alexey1234/arduino_hssp/schematic/README.md

# arduino_hssp programmer schematic

This is  my building of programmer hardware 

Such a complex circuit is needed because there are many more chips on my board that are powered by the same 5 Volt voltage. 

There are  many capacitors on the board also , so turning these 5 Volts on and off with a regular Arduino is quite problematic, an amplifier is needed

## My board

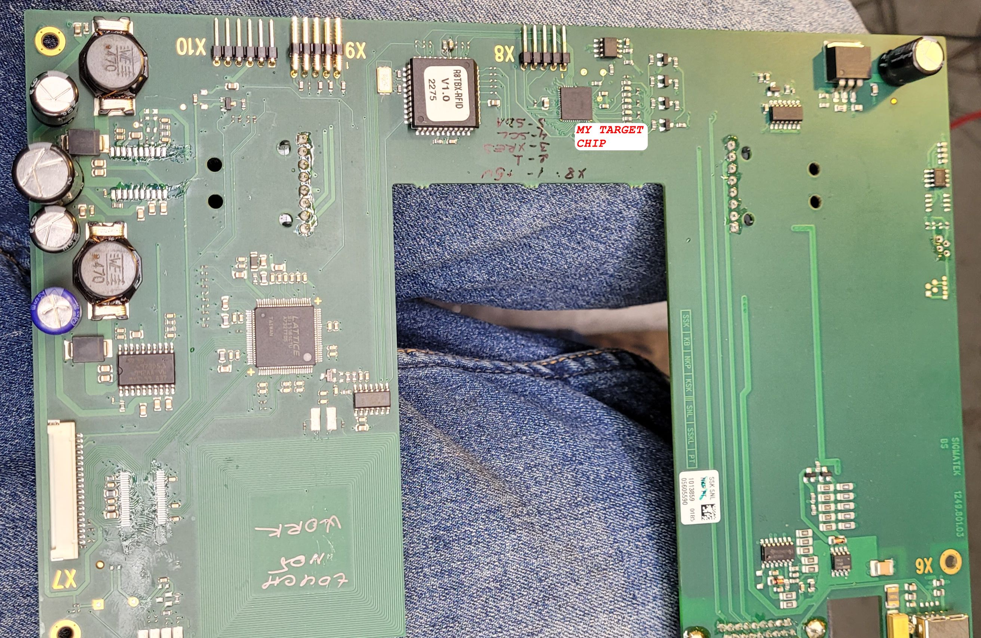
[picture p2: schematic/my target board.jpg]


## My programmer board schematic

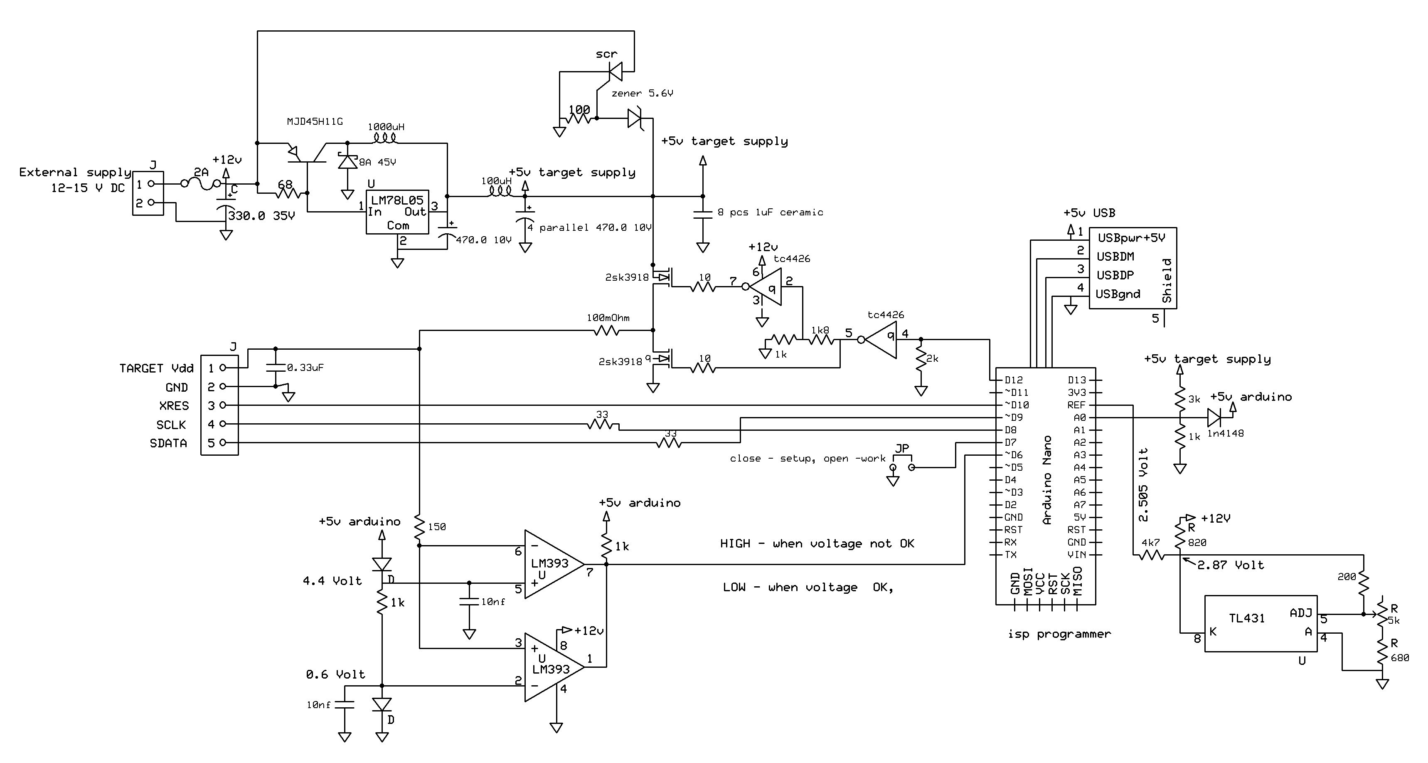
[picture p3: schematic/programmer_hard_V3.jpg]


I see more then 25 Amper peek curents during charge and discharge capacitor 100 uF on output.

I  use external voltage reference.

Time for charge and discharge some like 45 usec, so I add comparator for make delay as need.

[See test results](./test_result/README.md)
