alexey1234/arduino_hssp/linux/Cypress_psoc_tool/README.md

# Disc
This is copy of <https://github.com/trou/cypress_psoc_tools> 
trou, thank you very much for your work

# cypress_psoc_tools
Hackish tools to mess with Cypress PSoC 1, using an Arduino and <https://github.com/trou/arduino_hssp>

Example use case:
<https://syscall.eu/blog/2018/03/12/aigo_part2/>
