alexey1234/arduino_hssp/docs/execution of arduino command time.pdf

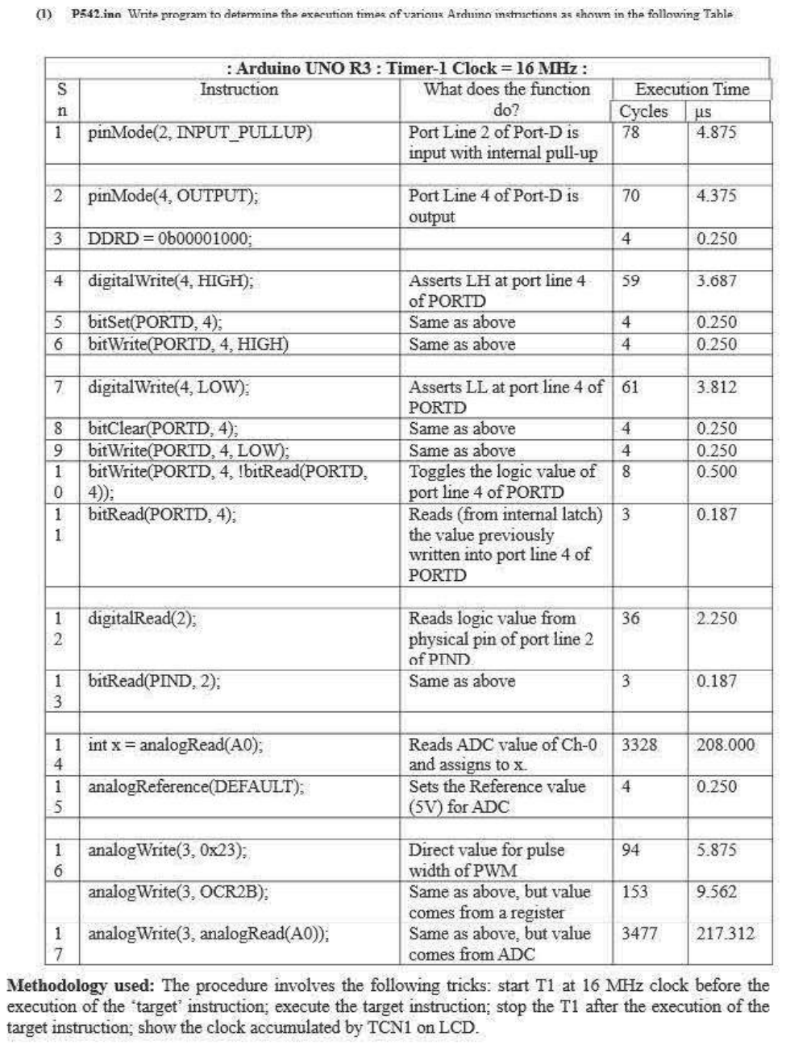
[picture p6: page 1]
