alexey1234/arduino_hssp/schematic/programmer.jpg

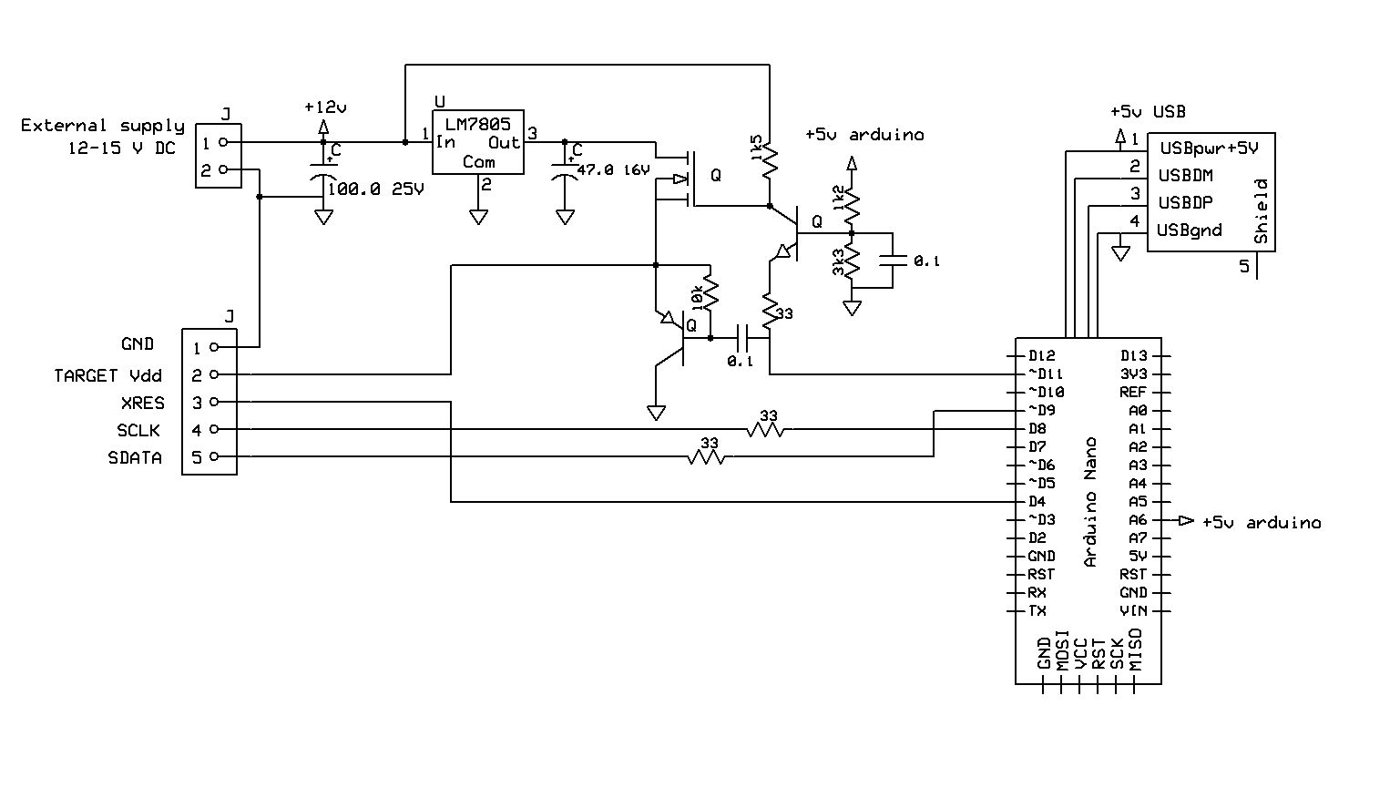
schematic/programmer.jpg
