alexey1234/arduino_hssp/schematic/programmer_V2.jpg

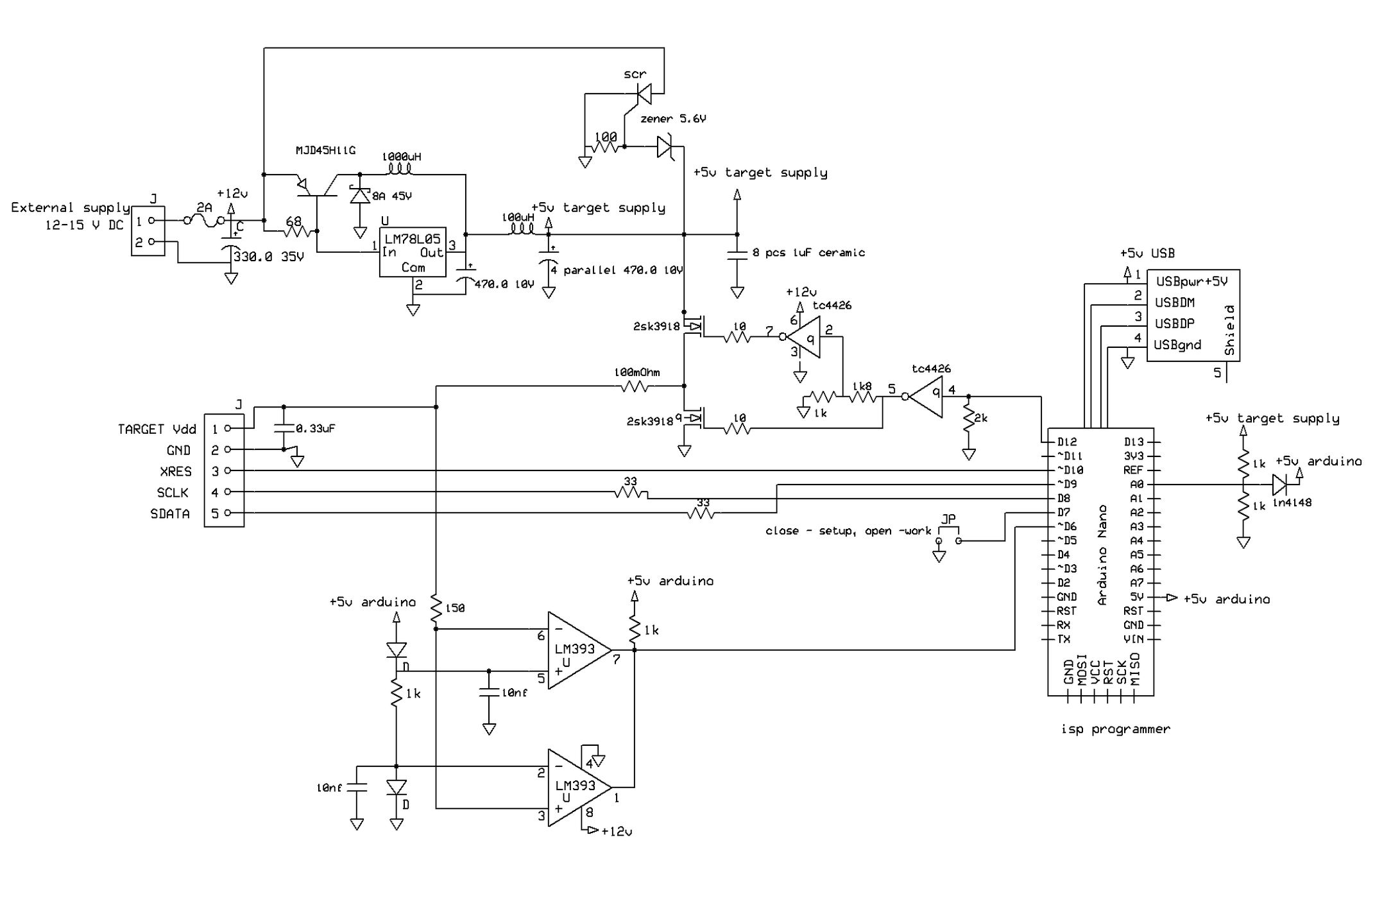
schematic/programmer_V2.jpg
