alexey1234/arduino_hssp/schematic/test_result/programmer_hard.jpg

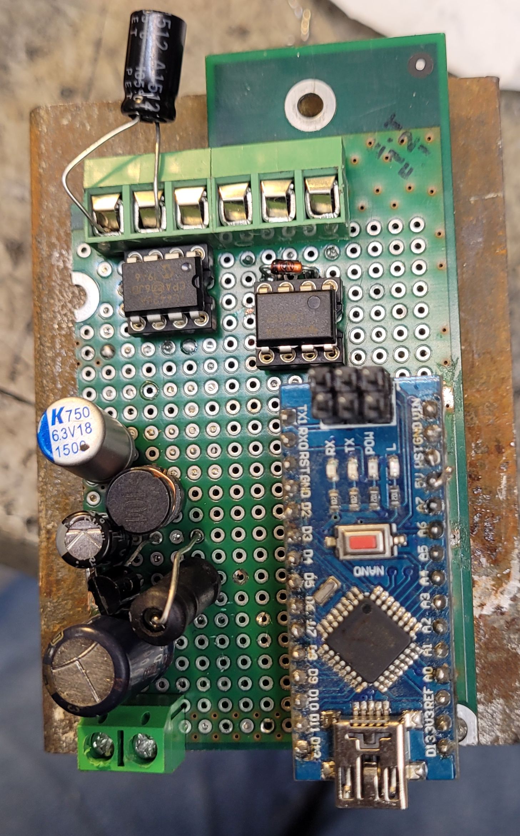
schematic/test_result/programmer_hard.jpg
