alexey1234/arduino_hssp/src/arduino_hssp.ino

/* Copyright 2006-2010, Cypress Semiconductor Corporation.
//
// This software is owned by Cypress Semiconductor Corporation (Cypress)
// and is protected by and subject to worldwide patent protection (United
// States and foreign), United States copyright laws and international 
// treaty provisions. Cypress hereby grants to licensee a personal, 
// non-exclusive, non-transferable license to copy, use, modify, create 
// derivative works of, and compile the Cypress Source Code and derivative 
// works for the sole purpose of creating custom software in support of 
// licensee product to be used only in conjunction with a Cypress integrated 
// circuit as specified in the applicable agreement. Any reproduction, 
// modification, translation, compilation, or representation of this 
// software except as specified above is prohibited without the express 
// written permission of Cypress.
//
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
// Use may be limited by and subject to the applicable Cypress software
// license agreement.
//
//---------------------------------------------------------------------------*/

/* ############################################################################
   ######  This version is configured to program HOTAS Warthog throttle  ######
   #####################   with an Arduino Pro Micro   ########################
   ##########################################################################*/

/* Pinout (see issp_defs.h):
   PCB - Arduino
   -------------
     1 - RAW
     2 - GND
     3 - 4
     4 - 8
     5 - 9
*/

/* ############################################################################
   ###################  CRITICAL PROJECT CONSTRAINTS   ########################
   ############################################################################ 

   ISSP programming can only occur within a temperature range of 5C to 50C.
   - This project is written without temperature compensation and using
     programming pulse-widths that match those used by programmers such as the
     Mini-Prog and the ISSP Programmer.
     This means that the die temperature of the PSoC device cannot be outside
     of the above temperature range.
     If a wider temperature range is required, contact your Cypress Semi-
     conductor FAE or sales person for assistance.

   The project can be configured to program devices at 5V or at 3.3V.
   - Initialization of the device is different for different voltages. The 
     initialization is hardcoded and can only be set for one voltage range.
     The supported voltages ranges are 3.3V (3.0V to 3.6V) and 5V (4.75V to
     5.25V). See the device datasheet for more details. If varying voltage
     ranges must be supported, contact your Cypress Semiconductor FAE or sales
     person for assistance.
   - ISSP programming for the 2.7V range (2.7V to 3.0V) is not supported.

   This program does not support programming all PSoC Devices 
   - It does not support obsoleted PSoC devices. A list of devices that are
     not supported is shown here:
         CY8C22x13 - not supported
         CY8C24x23 - not supported (CY8C24x23A is supported)
         CY8C24x33 - not supported
         CY8C25x43 - not supported
         CY8C26x43 - not supported
		 
   - Note: There is another application note (AN59389) that supports HSSP programming
     for CY8C20xx6, CY8CTMG2xx, CY8CTST2xx.
	 
   - It does not suport devices that have not been released for sale at the 
     time this version was created. If you need to ISSP program a newly released
     device, please contact Cypress Semiconductor Applications, your FAE or 
     sales person for assistance.
     The CY8C20x23 devices are not supported at the time of this release.

   ############################################################################ 
   ##########################################################################*/

     
/* This program uses information found in Cypress Semiconductor application 
// notes "Programming - In-System Serial Programming Protocol", AN2026.  The 
// version of this application note that applies to the specific PSoC that is
// being In-System Serial Programmed should be read and and understood when 
// using this program. (http://www.cypress.com)

// This project is included with releases of PSoC Programmer software. It is 
// important to confirm that the latest revision of this software is used when
// it is used. The revision of this copy can be found in the Project History 
// table below.
*/

/*/////////////////////////////////////////////////////////////////////////////
//  PROJECT HISTORY
//  date      revision  author  description
//  --------  --------  ------  -----------------------------------------------
//
//  12/06/10  ?2.30?     vvsk   1. Added support for CY8C21x45, CY8C22x45, CY8C23x33 
//
//                              2. Changed Revision to REV230
// 
//  xx/xx/10  ?2.20?     xch    1. Added support for CY8C20x34, CY8CTST110, CY8CTST120, 
//                              CY8CTMG110, CY8CTMG120, CY8CTMA120, 
//
//                              2. Aligned the order of parameters for LoadProgramData 
//                                 per CDT45137 
//
//                              3. Changed timing equation since CPU is now at 12MHz
//                                 instead of 24MHz.  Equation is now 2x+7 was 1x+3
//
//                              4. Changed Revision to REV220
//
//	02/09/09  2.12       fkl    1. Added vectors and constant defs for CY8C28xxx.
//
//								2. Changed constant definitions in files
//								issp_directives.h, issp_vectors.h and issp_defs.h.
//
//								3. Changed version number to REV212
//
//  09/23/07  2.11       dkn    1. Added searchable comments for the HSSP app note.
//
//                              2. Added new device vectors.
//
//                              3. Verified write and erase pulsewidths.
//
//                              4. Modified some functions for easier porting to
//                              other processors.
//
//  09/23/06  2.10       mwl    1. Added #define SECURITY_BYTES_PER_BANK to
//                              file issp_defs.h. Modified function
//                              fSecureTargetFlashMain() in issp_routines.c
//                              to use new #define. Modified function
//                              fLoadSecurityData() in issp_driver_routines.c
//                              to accept a bank number.  Modified the secure
//                              data loop in main.c to program multiple banks.
//
//                              2. Created function fAccTargetBankChecksum to
//                              read and add the target bank checksum to the
//                              referenced accumulator.  This allows the
//                              checksum loop in main.c to function at the
//                              same level of abstraction as the other
//                              programming steps.  Accordingly, modified the 
//                              checksum loop in main.c.  Deleted previous
//                              function fVerifyTargetChecksum().
//
//  09/08/06  2.00       mwl    1. Array variable abTargetDataOUT was not
//                              getting intialized anywhere and compiled as a
//                              one-byte array. Modified issp_driver_routines.c
//                              line 44 to initialize with TARGET_DATABUFF_LEN.
//
//                              2. Function void LoadProgramData(unsigned char
//                              bBlockNum) in issp_driver_routines.c had only
//                              one parameter bBlockNum but was being called
//                              from function main() with two parameters,
//                              LoadProgramData(bBankCounter, (unsigned char)
//                              iBlockCounter).  Modified function 
//                              LoadProgramData() to accept both parameters,
//                              and in turn modified InitTargetTestData() to 
//                              accept and use both as well.
//
//                              3. Corrected byte set_bank_number[1]
//                              inissp_vectors.h.  Was 0xF2, correct value is
//                              0xE2.
//
//                              4. Corrected the logic to send the SET_BANK_NUM
//                              vectors per the AN2026B flow chart.The previous
//                              code version was sending once per block, but
//                              should have been once per bank.  Removed the
//                              conditionally-compiled bank setting code blocks
//                              from the top of fProgramTargetBlock() and
//                              fVerifyTargetBlock() int issp_routines.c and
//                              created a conditionally-compiled subroutine in
//                              that same file called SetBankNumber().  Two
//                              conditionally-compiled calls to SetBankNumber()
//                              were added to main.c().
//
//                              5. Corrected CY8C29x66 NUM_BANKS and
//                              BLOCKS_PER_BANK definitions in ISSP_Defs.h.
//                              Was 2 and 256 respectively, correct values are
//                              4 and 128.
//
//                              6. Modified function fVerifyTargetChecksum()
//                              in issp_routines.c to read and accumulate multiple
//                              banks of checksums as required for targets
//                              CY8C24x94 and CY8C29x66.  Would have kept same
//                              level of abstraction as other multi-bank functions
//                              in main.c, but this implementation impacted the
//                              code the least.
//
//                              7. Corrected byte checksum_v[26] of
//                              CHECKSUM_SETUP_24_29 in issp_vectors.h.  Was 0x02,
//                              correct value is  0x04.
//
//  06/30/06  1.10       jvy    Added support for 24x94 and 29x66 devices.
//  06/09/06  1.00       jvy    Changed CPU Clk to 12MHz (from 24MHz) so the 
//                              host can run from 3.3V.
//                              Simplified init of security data.
//  06/05/06  0.06       jvy    Version #ifdef added to each file to make sure
//                              all of the file are from the same revision.
//                              Added flags to prevent multiple includes of H
//                              files.
//                              Changed pre-determined data for demo to be 
//                              unique for each block.
//                              Changed block verify to check all blocks after
//                              block programming has been completed.
//                              Added SetSCLKHiZ to explicitly set the Clk to 
//                              HighZ before power cycle acquire.
//                              Fixed wrong vectors in setting Security.
//                              Fixed wrong vectors in Block program.
//                              Added support for pods
//  06/05/06  0.05       jvy    Comments from code review. First copy checked
//                              into perforce.  Code has been updated enough to
//                              compile, by implementing some comments and
//                              fixing others.
//  06/04/06  0.04       jvy    made code more efficient in bReceiveByte(), and
//                              SendVector() by re-arranging so that local vars
//                              could be eliminated.
//                              added defines for the delays used in the code.
//  06/02/06  0.03       jvy    added number of Flash block adjustment to 
//                              programming. added power cycle programming
//                              mode support. This is the version initially 
//                              sent out for peer review.
//  06/02/06  0.02       jvy    added framework for multiple chip support from 
//                              one source code set using compiler directives.
//                              added timeout to high-low trasition detection.
//                              added multiple error message to allow tracking
//                              of failures.
//  05/30/06  0.01       jvy    initial version,
//                              created from DBD's issp_27xxx_v3 program.
/////////////////////////////////////////////////////////////////////////////*/

/* (((((((((((((((((((((((((((((((((((((())))))))))))))))))))))))))))))))))))))
 PSoC In-System Serial Programming (ISSP) Template
 This PSoC Project is designed to be used as a template for designs that
 require PSoC ISSP Functions.
 
 This project is based on the AN2026 series of Application Notes. That app
 note should be referenced before any modifications to this project are made.
 
 The subroutines and files were created in such a way as to allow easy cut & 
 paste as needed. There are no customer-specific functions in this project. 
 This demo of the code utilizes a PSoC as the Host.
 
 Some of the subroutines could be merged, or otherwise reduced, but they have
 been written as independently as possible so that the specific steps involved
 within each function can easily be seen. By merging things, some code-space 
 savings could be realized. 
 
 As is, and with all features enabled, the project consumes approximately 3500
 bytes of code space, and 19-Bytes of RAM (not including stack usage). The
 Block-Verify requires a 64-Byte buffer for read-back verification. This same
 buffer could be used to hold the (actual) incoming program data.
 
 Please refer to the compiler-directives file "directives.h" to see the various
 features.
 
 The pin used in this project are assigned as shown below. The HOST pins are 
 arbitrary and any 3 pins could be used (the masks used to control the pins 
 must be changed). The TARGET pins cannot be changed, these are fixed function
 pins on the PSoC. 
 The PWR pin is used to provide power to the target device if power cycle
 programming mode is used. The compiler directive RESET_MODE in ISSP_directives.h
 is used to select the programming mode. This pin could control the enable on
 a voltage regulator, or could control the gate of a FET that is used to turn
 the power to the PSoC on.
 The TP pin is a Test Point pin that can be used signal from the host processor
 that the program has completed certain tasks. Predefined test points are
 included that can be used to observe the timing for bulk erasing, block 
 programming and security programming.
 
      SIGNAL  HOST  TARGET
      ---------------------
      SDATA   P1.0   P1.0
      SCLK    P1.1   P1.1
      XRES    P2.0   XRES
      PWR     P2.1   Vdd 
      TP      P0.7   n/a
 
 For test & demonstration, this project generates the program data internally. 
 It does not take-in the data from an external source such as I2C, UART, SPI,
 etc. However, the program was written in such a way to be portable into such
 designs. The spirit of this project was to keep it stripped to the minimum 
 functions required to do the ISSP functions only, thereby making a portable 
 framework for integration with other projects.

 The high-level functions have been written in C in order to be portable to
 other processors. The low-level functions that are processor dependent, such 
 as toggling pins and implementing specific delays, are all found in the file
 ISSP_Drive_Routines.c. These functions must be converted to equivalent
 functions for the HOST processor.  Care must be taken to meet the timing 
 requirements when converting to a new processor. ISSP timing information can
 be found in Application Note AN2026.  All of the sections of this program
 that need to be modified for the host processor have "PROCESSOR_SPECIFIC" in
 the comments. By performing a "Find in files" using "PROCESSOR_SPECIFIC" these
 sections can easily be identified.

 The variables in this project use Hungarian notation. Hungarian prepends a
 lower case letter to each variable that identifies the variable type. The
 prefixes used in this program are defined below:
  b = byte length variable, signed char and unsigned char
  i = 2-byte length variable, signed int and unsigned int
  f = byte length variable used as a flag (TRUE = 0, FALSE != 0)
  ab = an array of byte length variables


 After this program has been ported to the desired host processor the timing
 of the signals must be confirmed.  The maximum SCLK frequency must be checked
 as well as the timing of the bulk erase, block write and security write
 pulses.
 
 The maximum SCLK frequency for the target device can be found in the device 
 datasheet under AC Programming Specifications with a Symbol of "Fsclk".
 An oscilloscope should be used to make sure that no half-cycles (the high 
 time or the low time) are shorter than the half-period of the maximum
 freqency. In other words, if the maximum SCLK frequency is 8MHz, there can be
 no high or low pulses shorter than 1/(2*8MHz), or 62.5 nsec.

(((((((((((((((((((((((((((((((((((((()))))))))))))))))))))))))))))))))))))) */



/*----------------------------------------------------------------------------
//                               C main line
//----------------------------------------------------------------------------
*/
// Before compile sketch choice chip or chip family, as you need
//In case other chip comment next line and uncommet your line
// IMPORTANT! Also need add to psocdude.conf in Linux host values about flash memory !
#define CY8C24x94
// #define CY8CTST110
// #define CY8CTST120
// #define CY8CTMG110
// #define CY8CTMG120
// #define CY8C21x23
// #define CY8C21x34
// #define CY8C21x45
// #define CY8C22x45
// #define CY8C23x33
// #define CY8C24x23A
// #define CY8C24x94
// #define CY8C27x43
// #define CY8C28xxx
// #define CY8C29x66


// 	Also revise setup() and correct values in this sections

// /*******CHIP SPECIFIC  ******/  
/*  param.prog_mode = RESET_MODE;
    param.targ_voltage = TARGET_VOLTAGE_5V;
    param.chksm_setup = CHECKSUM_SETUP_22_24_28_29_TST120_TMG120_TMA120;
    param.prgm_block = PROGRAM_BLOCK_21_22_23_24_28_29_TST_TMG_TMA;
    param.multi_bank = false;
    //END CHIP SPECIFIC */

#define TARGET_VOLTAGE_IS_5V
#define SERIAL_TX_BUFFER_SIZE 256
//added volatile uint8_t POWER_CYCLE_DELAY = 150;
// ------ Declarations Associated with ISSP Files & Routines -------
//     Add these to your project as needed.
#include "issp_extern.h" // 
#include "issp_defs.h"
#include "issp_errors.h"
#include "stk500_protocol.h"
#include <EEPROM.h>

#define HWVER 2
#define SWMAJ 1
#define SWMIN 18

unsigned char bBankCounter;
unsigned int  iBlockCounter;
unsigned int  iChecksumData;
unsigned int  iChecksumTarget;
unsigned char comspeed;

parameter param;

int error=0;
int pmode=0;
int here;
uint8_t buff[256]; // global block storage
unsigned char bit;
volatile unsigned char *out;
int psocisp();
unsigned long old_tick = 0;



uint8_t getch() {
  while(!Serial.available());
  return Serial.read();
}

void empty_reply() {
  if (Sync_CRC_EOP == getch()) {
    Serial.print((char)Resp_STK_INSYNC);
    Serial.print((char)Resp_STK_OK);
  } else {
    error++;
    Serial.print((char)Resp_STK_NOSYNC);
  }
}

void breply(uint8_t b) {
  if (Sync_CRC_EOP == getch()) {
    Serial.print((char)Resp_STK_INSYNC);
    Serial.print((char)b);
    Serial.print((char)Resp_STK_OK);
  } else {
    error++;
    Serial.print((char)Resp_STK_NOSYNC);
  }
}

void fill(int n) {
  for (int x = 0; x < n; x++) {
    buff[x] = getch();
  }
}

void get_parameter(uint8_t c) {
  switch(c) {
    case Parm_STK_HW_VER:
      breply(HWVER);
      break;
    case Parm_STK_SW_MAJOR:
      breply(SWMAJ);
      break;
    case Parm_STK_SW_MINOR:
      breply(SWMIN);
      break;
    case Parm_STK_PROGMODE:
      breply('S'); // serial programmer
      break;
    case Parm_STK_VTARGET:
      breply(50);
    default:
      breply(0);
  }
}

void set_parameters() {
  // call this after reading paramter packet into buff[]
  param.prog_mode = (programming_mode) buff[0];
  param.targ_voltage = (target_voltage) buff[1];
  param.chksm_setup = (checksum_setup) buff[2];
  param.prgm_block = (prg_block) buff[3];
  param.multi_bank = (boolean) buff[4];
}

void end_pmode() {
  ReStartTarget();
}

int8_t erase_chip() {
  return fEraseTarget();
}

// Initialize the Host & Target for ISSP operations
int8_t start_pmode() {
  // Acquire the device through reset or power cycle
  int8_t result = PASS;
  if(param.prog_mode == RESET_MODE) {
    fXRESInitializeTargetForISSP();
  } else {
    result = fPowerCycleInitializeTargetForISSP();
  }
  
  if (Sync_CRC_EOP == getch()) {
      Serial.print((char)Resp_STK_INSYNC);
      if (result)
            Serial.print((char) Resp_STK_FAILED);
      else
            Serial.print((char) Resp_STK_OK);
  } else {
    error++;
    Serial.print((char)Resp_STK_NOSYNC);
  }
  

  pmode = 1;
  return result;
}

void read_signature() {
  if (Sync_CRC_EOP != getch()) {
    error++;
    Serial.print((char) Resp_STK_NOSYNC);
    return;
  }

  if(getSiliconID(buff)) {
    Serial.print((char) Resp_STK_FAILED);
    return;
  }
  Serial.print((char) Resp_STK_INSYNC);
  Serial.print((char) buff[0]);
  Serial.print((char) buff[1]);
  Serial.print((char) Resp_STK_OK);
}

char flash_read_page(int length) {
  for (uint8_t x = 0; x < length; x++) {
    Serial.write(readByte(0x80+x));
  }
  return Resp_STK_OK;
}

void read_mem() {
  char result = (char)Resp_STK_FAILED;
  int addr = getch();
  if (Sync_CRC_EOP != getch()) {
    error++;
    Serial.print((char) Resp_STK_NOSYNC);
    return;
  }
  Serial.print((char) Resp_STK_INSYNC);
  result = readByte(addr);
  Serial.print(result);
  Serial.print((char) Resp_STK_OK);
  return;
}

void write_mem() {
  int addr = getch();
  int value = getch();
  if (Sync_CRC_EOP != getch()) {
    error++;
    Serial.print((char) Resp_STK_NOSYNC);
    return;
  }
  writeByte(addr, value);
  Serial.print((char) Resp_STK_INSYNC);
  Serial.print((char) Resp_STK_OK);
  return;
}

void read_reg() {
  char result = (char)Resp_STK_FAILED;
  int addr = getch();
  if (Sync_CRC_EOP != getch()) {
    error++;
    Serial.print((char) Resp_STK_NOSYNC);
    return;
  }
  Serial.print((char) Resp_STK_INSYNC);
  result = readReg(addr);
  Serial.print(result);
  Serial.print((char) Resp_STK_OK);
  return;
}

uint8_t read_romx(uint16_t address) {
    writeReg(0xF0, address>>8); // A = 0
    writeReg(0xF3, address&0xFF); // X = 0
    unsigned char opc[3] = {0x28,0x30, 0x40}; //ROMX HALT NOP
    Exec(opc);
    return readReg(0xF0);
}


void write_reg() {
  int addr = getch();
  int value = getch();
  if (Sync_CRC_EOP != getch()) {
    error++;
    Serial.print((char) Resp_STK_NOSYNC);
    return;
  }
  writeReg(addr, value);
  Serial.print((char) Resp_STK_INSYNC);
  Serial.print((char) Resp_STK_OK);
  return;
}

void exec_opcodes() {
  unsigned char opc[3];
  opc[0] = getch();
  opc[1] = getch();
  opc[2] = getch();

  if (Sync_CRC_EOP != getch()) {
    error++;
    Serial.print((char) Resp_STK_NOSYNC);
    return;
  }
  Exec(opc);
  Serial.print((char) Resp_STK_INSYNC);
  Serial.print((char) Resp_STK_OK);
  return;
}

void read_page() {
  char result = (char)Resp_STK_FAILED;
  int length = 256 * getch();
  length += getch();
  char memtype = getch();
  if (Sync_CRC_EOP != getch()) {
    error++;
    Serial.print((char) Resp_STK_NOSYNC);
    return;
  }
  Serial.print((char) Resp_STK_INSYNC);
  if (memtype == 'F') {
    result = flash_read_page(length);
  }
  Serial.print(result);
  return;
}

uint8_t write_flash_pages(int length) {
  for (bTargetDataPtr = 0; bTargetDataPtr < TARGET_DATABUFF_LEN; bTargetDataPtr++) {
    abTargetDataOUT[bTargetDataPtr] = buff[bTargetDataPtr];
  }
  iLoadTarget();
  fProgramTargetBlock(0, here);
  return Resp_STK_OK;
}

void write_flash(int length) {
  fill(length);
  if (Sync_CRC_EOP == getch()) {
    Serial.print((char) Resp_STK_INSYNC);
    Serial.print((char) write_flash_pages(length));
  } else {
    error++;
    Serial.print((char) Resp_STK_NOSYNC);
  }
}

void program_page() {
  int length = 256 * getch();
  length += getch();
  char memtype = getch();
  // flash memory @here, (length) bytes
  if (memtype == 'F') {
    write_flash(length);
    return;
  } else {
    error++;
    Serial.print((char) Resp_STK_NOSYNC);
  }
  Serial.print((char)Resp_STK_FAILED);
  return;
}
void prepare_target_reconnect() {
	// This subroutine make pins to highZ state and switch Target voltage off
	// For safely remove connector from working  board
	SetSCLKHiZ();
	SetSDATAHiZ();
	pinMode(XRES_PIN, INPUT);
	digitalWrite(XRES_PIN, LOW);
	RemoveTargetVDD();
}

	

void setup() {
  analogReference(EXTERNAL);
	bit = digitalPinToBitMask(SDATA_PIN);
	out = portOutputRegister(digitalPinToPort(SDATA_PIN));
	SetTargetVDDStrong();
	pinMode(SETUP_PIN, INPUT_PULLUP);
	pinMode(COMP_PIN, INPUT_PULLUP);
	pinMode(LED_BUILTIN, OUTPUT);
	digitalWrite  (LED_BUILTIN, LOW);
	prepare_target_reconnect();
	while (!digitalRead(SETUP_PIN)){
		Serial.begin(57600);
		set_prog();
		Serial.flush();
		Serial.end();
		} 
	//setup for works
	
	comspeed = EEPROM.read(0);
	switch (comspeed) {
			case 0:
				Serial.begin(115200);
			break;
			case 1:
				Serial.begin(57600);
			break;
			case 2:
				Serial.begin(38400);
			break;
			case 3:
				Serial.begin(19200);
			break;
			default:
			 Serial.begin(57600);
			break;
	}
	/*******CHIP SPECIFIC  ******/
    param.prog_mode = RESET_MODE;
    param.targ_voltage = TARGET_VOLTAGE_5V;
    param.chksm_setup = CHECKSUM_SETUP_22_24_28_29_TST120_TMG120_TMA120;
    param.prgm_block = PROGRAM_BLOCK_21_22_23_24_28_29_TST_TMG_TMA;
    param.multi_bank = false;
     //END CHIP SPECIFIC
    old_tick = millis();
}

void loop() {
	

  if (Serial.available()) {
	digitalWrite(LED_BUILTIN, HIGH);
	ApplyTargetVDD(); 
	psocisp();
	digitalWrite(LED_BUILTIN, LOW);
	old_tick = millis();
  } else {
	unsigned long current_tick = millis();
	if (current_tick - old_tick >= 3000) {
			old_tick = current_tick;
			prepare_target_reconnect();
			digitalWrite(LED_BUILTIN, LOW);
			// remove after test
    // Serial.println("speedtest");
		}
	}
}
int psocisp() {
  uint8_t res, block_count;
  uint32_t checksum_delay = 0, ms_delay = 0;
  uint8_t ch = getch();
  unsigned int csum = 0;
 
  switch (ch) {
    case Cmnd_STK_GET_SYNC: // signon
      error = 0;
      empty_reply();
      break;
    case Cmnd_STK_GET_SIGN_ON:
      if (getch() == Sync_CRC_EOP) {
        Serial.print((char) Resp_STK_INSYNC);
        Serial.print("AVR ISP");
        Serial.print((char) Resp_STK_OK);
      }
      break;
    case Cmnd_STK_GET_PARAMETER:
      get_parameter(getch());
      break;
    case Cmnd_STK_SET_DEVICE:
      fill(5);
      set_parameters();
      empty_reply();
      break;
    case Cmnd_STK_SET_DEVICE_EXT: // extended parameters - ignore for now
      fill(5);
      empty_reply();
      break;
    case Cmnd_STK_ENTER_PROGMODE:
      start_pmode();
      break;
    case Cmnd_STK_INIT_PROGMODE:
      res = SendInitVectors();
      start_pmode();
      break;
    case Cmnd_STK_CHIP_ERASE:
      erase_chip();
      empty_reply();
      break;
    case Cmnd_STK_LOAD_ADDRESS: // set address (word)
      here = getch();
      here += 256 * getch();
      here /= 64;
      setAddress(here / BLOCKS_PER_BANK, (here % BLOCKS_PER_BANK)); 
      empty_reply();
      break;
    case Cmnd_STK_PROG_PAGE:
      program_page();
      break;
    case Cmnd_STK_READ_PAGE:
      read_page();    
      break;
    case Cmnd_STK_READ_MEM:
      read_mem();
      break;
    case Cmnd_STK_WRITE_MEM:
      write_mem();
      break;
    case Cmnd_STK_READ_REG:
      read_reg();
      break;
    case Cmnd_STK_READ_SECURITY:
      res = fVerifySecurity();
      Serial.print((char) Resp_STK_INSYNC);
      Serial.print((char) res);
      Serial.print((char) Resp_STK_OK);
      break;
    case Cmnd_STK_WRITE_REG:
      write_reg();
      break;
    case Cmnd_STK_EXEC_OPCODES:
      exec_opcodes();
      break;
    case Cmnd_STK_RUN_CSUM:
      block_count = getch();
      fAccTargetBankChecksum(&csum, block_count);
      Serial.print((char) Resp_STK_INSYNC);
      Serial.print((char)(csum&0xFF));
      Serial.print((char)((csum>>8)&0xFF));
      Serial.print((char) Resp_STK_OK);
      break;
    case Cmnd_STK_START_CSUM:
      checksum_delay = ((uint32_t)getch())<<24;
      checksum_delay |= ((uint32_t)getch())<<16;
      checksum_delay |= ((uint32_t)getch())<<8;
      checksum_delay |= getch();
      if(checksum_delay > 10000) {
         ms_delay = checksum_delay/1000;
         checksum_delay = checksum_delay%1000;
      }
      else {
         ms_delay = 0;
      }
      send_checksum_v();
      if (checksum_delay)
          delayMicroseconds(checksum_delay);
      delay(ms_delay);
      start_pmode();
      break;
    case Cmnd_STK_LEAVE_PROGMODE:
      error=0;
      end_pmode();
      empty_reply();
      break;
    case Cmnd_STK_READ_SIGN:
      read_signature();
      break;

      // expecting a command, not Sync_CRC_EOP
      // this is how we can get back in sync
    case Sync_CRC_EOP:
      error++;
      Serial.print((char) Resp_STK_NOSYNC);
      break;

      // anything else we will return Resp_STK_UNKNOWN
    default:
      error++;
      if (Sync_CRC_EOP == getch())
        Serial.print((char)Resp_STK_UNKNOWN);
      else
        Serial.print((char)Resp_STK_NOSYNC);
  }
	
  return 0;

}
