alexey1234/arduino_hssp/src/issp_driver_routines.cpp

#include "Arduino.h"
// Copyright 2006-2010, Cypress Semiconductor Corporation.
//
// This software is owned by Cypress Semiconductor Corporation (Cypress)
// and is protected by and subject to worldwide patent protection (United
// States and foreign), United States copyright laws and international 
// treaty provisions. Cypress hereby grants to licensee a personal, 
// non-exclusive, non-transferable license to copy, use, modify, create 
// derivative works of, and compile the Cypress Source Code and derivative 
// works for the sole purpose of creating custom software in support of 
// licensee product to be used only in conjunction with a Cypress integrated 
// circuit as specified in the applicable agreement. Any reproduction, 
// modification, translation, compilation, or representation of this 
// software except as specified above is prohibited without the express 
// written permission of Cypress.
//
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
// Use may be limited by and subject to the applicable Cypress software
// license agreement.
//
//--------------------------------------------------------------------------
#include <EEPROM.h>
#include "issp_defs.h"
#include "issp_extern.h"
#include "issp_errors.h"

// ============================================================================
// LoadArrayWithSecurityData()
// !!!!!!!!!!!!!!!!!!FOR TEST!!!!!!!!!!!!!!!!!!!!!!!!!!
// PROCESSOR_SPECIFIC
// Most likely this data will be fed to the Host by some other means, ie: I2C,
// RS232, etc., or will be fixed in the host. The security data should come
// from the hex file.
//   bStart  - the starting byte in the array for loading data
//   bLength - the number of byte to write into the array 
//   bType   - the security data to write over the range defined by bStart and
//             bLength
// ============================================================================
/*void LoadArrayWithSecurityData(unsigned char bStart, unsigned char bLength, unsigned char bType)
{
    // Now, write the desired security-bytes for the range specified
    for (bTargetDataPtr = bStart; bTargetDataPtr < bLength; bTargetDataPtr++) {
        abTargetDataOUT[bTargetDataPtr] = bType;
    }
}*/

// ********************* LOW-LEVEL ISSP SUBROUTINE SECTION ********************
// ****************************************************************************
// ****                        PROCESSOR SPECIFIC                          ****
// ****************************************************************************
// ****                      USER ATTENTION REQUIRED                       ****
// ****************************************************************************
// fLoadSecurityData()
// Load security data from hex file into 64 byte host ram buffer. In a fully 
// functional program (not a demo) this routine should do the following:
//    1. Read data from security record in hex file into ram buffer. 
//    2. Check host ram buffer + record data (Address, # of bytes) against hex
//       record checksum at end of record line
//    3. If error reread security data from file or abort
//    4. Exit this Function and Program block
// In this demo routine, all of the security data is set to unprotected (0x00)
// and it returns.
// This function always returns PASS. The flag return is reserving
// functionality for non-demo versions.
// ****************************************************************************
/*signed char fLoadSecurityData(unsigned char bBankNum)
{
    // >>> The following call is for demo use only. <<<
    // Function LoadArrayWithSecurityData fills buffer for demo
    LoadArrayWithSecurityData(0,SECURITY_BYTES_PER_BANK, 0x00);
    
    // Note:
    // Error checking should be added for the final version as noted above.
    // For demo use this function just returns PASS.
    return(PASS);
}*/


// ********************* LOW-LEVEL ISSP SUBROUTINE SECTION ********************
// ****************************************************************************
// ****                        PROCESSOR SPECIFIC                          ****
// ****************************************************************************
// ****                      USER ATTENTION REQUIRED                       ****
// ****************************************************************************
// fSDATACheck()
// Check SDATA pin for high or low logic level and return value to calling
// routine.
// Returns:
//     0 if the pin was low.
//     1 if the pin was high.
// ****************************************************************************
unsigned char fSDATACheck(void)
{
    return digitalRead(SDATA_PIN);
}
        

// ********************* LOW-LEVEL ISSP SUBROUTINE SECTION ********************
// ****************************************************************************
// ****                        PROCESSOR SPECIFIC                          ****
// ****************************************************************************
// ****                      USER ATTENTION REQUIRED                       ****
// ****************************************************************************        
// SCLKHigh()
// Set the SCLK pin High
// ****************************************************************************        
void SCLKHigh(void)
{
    digitalWrite(SCLK_PIN, HIGH);
}


// ********************* LOW-LEVEL ISSP SUBROUTINE SECTION ********************
// ****************************************************************************
// ****                        PROCESSOR SPECIFIC                          ****
// ****************************************************************************
// ****                      USER ATTENTION REQUIRED                       ****
// ****************************************************************************
// SCLKLow()
// Make Clock pin Low
// ****************************************************************************
void SCLKLow(void)
{
    digitalWrite(SCLK_PIN, LOW);
}

// ********************* LOW-LEVEL ISSP SUBROUTINE SECTION ********************
// ****************************************************************************
// ****                        PROCESSOR SPECIFIC                          ****
// ****************************************************************************
// ****                      USER ATTENTION REQUIRED                       ****
// ****************************************************************************
// SetSCLKHiZ()
// Set SCLK pin to HighZ drive mode.
// ****************************************************************************
void SetSCLKHiZ(void)
{
    pinMode(SCLK_PIN, INPUT);
    digitalWrite(SCLK_PIN, LOW);
}

// ********************* LOW-LEVEL ISSP SUBROUTINE SECTION ********************
// ****************************************************************************
// ****                        PROCESSOR SPECIFIC                          ****
// ****************************************************************************
// ****                      USER ATTENTION REQUIRED                       ****
// ****************************************************************************
// SetSCLKStrong()
// Set SCLK to an output (Strong drive mode)
// ****************************************************************************
void SetSCLKStrong(void)
{
    pinMode(SCLK_PIN, OUTPUT);
}

// Arduinos digitalWrite function is to slow (violates timings), this is a workaround
void digitalWriteSDATA(unsigned char val) {
    if (val == LOW) {
        *out &= ~bit;
    } else {
        *out |= bit;
    }
}

// ********************* LOW-LEVEL ISSP SUBROUTINE SECTION ********************
// ****************************************************************************
// ****                        PROCESSOR SPECIFIC                          ****
// ****************************************************************************
// ****                      USER ATTENTION REQUIRED                       ****
// ****************************************************************************
// SetSDATAHigh()
// Make SDATA pin High
// ****************************************************************************
void SetSDATAHigh(void)
{
    digitalWriteSDATA(HIGH);
}

// ********************* LOW-LEVEL ISSP SUBROUTINE SECTION ********************
// ****************************************************************************
// ****                        PROCESSOR SPECIFIC                          ****
// ****************************************************************************
// ****                      USER ATTENTION REQUIRED                       ****
// ****************************************************************************
// SetSDATALow()
// Make SDATA pin Low
// ****************************************************************************
void SetSDATALow(void)
{
    digitalWriteSDATA(LOW);
}

// ********************* LOW-LEVEL ISSP SUBROUTINE SECTION ********************
// ****************************************************************************
// ****                        PROCESSOR SPECIFIC                          ****
// ****************************************************************************
// ****                      USER ATTENTION REQUIRED                       ****
// ****************************************************************************
// SetSDATAHiZ()
// Set SDATA pin to an input (HighZ drive mode).
// ****************************************************************************
void SetSDATAHiZ(void)
{
    pinMode(SDATA_PIN, INPUT);
    digitalWrite(SDATA_PIN, LOW);
}

// ********************* LOW-LEVEL ISSP SUBROUTINE SECTION ********************
// ****************************************************************************
// ****                        PROCESSOR SPECIFIC                          ****
// ****************************************************************************
// ****                      USER ATTENTION REQUIRED                       ****
// ****************************************************************************
// SetSDATAStrong()
// Set SDATA for transmission (Strong drive mode) -- as opposed to being set to
// High Z for receiving data.
// ****************************************************************************
void SetSDATAStrong(void)
{
    pinMode(SDATA_PIN, OUTPUT);
}

// ********************* LOW-LEVEL ISSP SUBROUTINE SECTION ********************
// ****************************************************************************
// ****                        PROCESSOR SPECIFIC                          ****
// ****************************************************************************
// ****                      USER ATTENTION REQUIRED                       ****
// ****************************************************************************
// SetXRESStrong()
// Set external reset (XRES) to an output (Strong drive mode).
// ****************************************************************************
void SetXRESStrong(void)
{
    pinMode(XRES_PIN, OUTPUT);
}

// ********************* LOW-LEVEL ISSP SUBROUTINE SECTION ********************
// ****************************************************************************
// ****                        PROCESSOR SPECIFIC                          ****
// ****************************************************************************
// ****                      USER ATTENTION REQUIRED                       ****
// ****************************************************************************
// AssertXRES()
// Set XRES pin High
// ****************************************************************************
void AssertXRES(void)
{
    digitalWrite(XRES_PIN, HIGH);
}

// ********************* LOW-LEVEL ISSP SUBROUTINE SECTION ********************
// ****************************************************************************
// ****                        PROCESSOR SPECIFIC                          ****
// ****************************************************************************
// ****                      USER ATTENTION REQUIRED                       ****
// ****************************************************************************
// DeassertXRES()
// Set XRES pin low.
// ****************************************************************************
void DeassertXRES(void)
{
    digitalWrite(XRES_PIN, LOW);
}

// ********************* LOW-LEVEL ISSP SUBROUTINE SECTION ********************
// ****************************************************************************
// ****                        PROCESSOR SPECIFIC                          ****
// ****************************************************************************
// ****                      USER ATTENTION REQUIRED                       ****
// ****************************************************************************
// SetTargetVDDStrong()
// Set VDD pin (PWR) to an output (Strong drive mode).
// ****************************************************************************
void SetTargetVDDStrong(void)
{
    pinMode(TARGET_VDD, OUTPUT);
}

// ********************* LOW-LEVEL ISSP SUBROUTINE SECTION ********************
// ****************************************************************************
// ****                        PROCESSOR SPECIFIC                          ****
// ****************************************************************************
// ****                      USER ATTENTION REQUIRED                       ****
// ****************************************************************************
// ApplyTargetVDD()
// Provide power to the target PSoC's Vdd pin through a GPIO.
// ****************************************************************************
void ApplyTargetVDD(void)
{
	volatile uint8_t POWER_CYCLE_DELAY_METHOD = EEPROM.read(9);
	uint16_t POWER_CYCLE_DELAY=0;
	EEPROM.get(10,POWER_CYCLE_DELAY);
    digitalWrite(TARGET_VDD, HIGH);
	delayMicroseconds(10);
	if (POWER_CYCLE_DELAY_METHOD == 0 ) 
	{
			while (bitRead(PIND, PIND6)==HIGH){}
			delayMicroseconds(100);
	} else {
		delayMicroseconds(POWER_CYCLE_DELAY);
	}
}

// ********************* LOW-LEVEL ISSP SUBROUTINE SECTION ********************
// ****************************************************************************
// ****                        PROCESSOR SPECIFIC                          ****
// ****************************************************************************
// ****                      USER ATTENTION REQUIRED                       ****
// ****************************************************************************
// RemoveTargetVDD()
// Remove power from the target PSoC's Vdd pin.
// ****************************************************************************
//temporary disabled

void RemoveTargetVDD(void)
{
	volatile uint8_t POWER_CYCLE_DELAY_METHOD = EEPROM.read(9);
	uint16_t POWER_CYCLE_DELAY=0;
	EEPROM.get(10,POWER_CYCLE_DELAY);
    digitalWrite(TARGET_VDD, LOW);
	delayMicroseconds(10);
	if (POWER_CYCLE_DELAY_METHOD == 0 ) {
		while (bitRead(PIND, PIND6)==HIGH){}
		delayMicroseconds(100);
	} else {
		delayMicroseconds(POWER_CYCLE_DELAY);
	}
}
