alexey1234/arduino_hssp/docs/HSSP_CY8Cxxxx/HSSP_CY8Cxxxx/HSSP_CY8Cxxxx/issp_packetlayer.c

// filename: ISSP_PacketLayer.c
// Copyright 2015, Cypress Semiconductor Corporation.
//
// This software is owned by Cypress Semiconductor Corporation (Cypress)
// and is protected by and subject to worldwide patent protection (United
// States and foreign), United States copyright laws and international 
// treaty provisions. Cypress hereby grants to licensee a personal, 
// non-exclusive, non-transferable license to copy, use, modify, create 
// derivative works of, and compile the Cypress Source Code and derivative 
// works for the sole purpose of creating custom software in support of 
// licensee product to be used only in conjunction with a Cypress integrated 
// circuit as specified in the applicable agreement. Any reproduction, 
// modification, translation, compilation, or representation of this 
// software except as specified above is prohibited without the express 
// written permission of Cypress.
//
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
// Use may be limited by and subject to the applicable Cypress software
// license agreement.
//
//--------------------------------------------------------------------------

#include <m8c.h>        // part specific constants and macros
#include "PSoCAPI.h"    // PSoC API definitions for all User Modules
#include "ISSP_Defs.h"
#include "ISSP_Vectors.h"
#include "ISSP_Extern.h"
#include "ISSP_Errors.h"
#include "ISSP_Directives.h"
#include "ISSP_Delays.h"
#include "ISSP_Revision.h"

#ifdef PROJECT_REV_300

unsigned char  bTargetDataIN;
unsigned char  abTargetDataOUT[TARGET_DATABUFF_LEN];

unsigned char  bTargetAddress;
unsigned char  bTargetDataPtr = 0;
unsigned char  bTargetID[2];

unsigned char  fIsError;

/* ((((((((((((((((((((( LOW-LEVEL ISSP SUBROUTINE SECTION ))))))))))))))))))))
   (( The subroutines in this section use functions from the C file          ))
   (( ISSP_PhysicalLayer.c. The functions in that file interface to the     ))
   (( processor specific hardware. So, these functions should work as is, if ))
   (( the routines in ISSP_PhysicalLayer.c are correctly converted.         ))
   (((((((((((((((((((((((((((((((((((())))))))))))))))))))))))))))))))))))))))*/

// ============================================================================
// RunClock()
// Description: 
// Run Clock without sending/receiving bits. Use this when transitioning from 
// write to read and read to write "num_cycles" is number of SCLK cycles, not
// number of counter cycles.
//
// SCLK cannot run faster than the specified maximum frequency of 8MHz. Some 
// processors may need to have delays added after setting SCLK low and setting
// SCLK high in order to not exceed this specification. The maximum frequency 
// of SCLK should be measured as part of validation of the final program
//
// ============================================================================
void RunClock(unsigned int iNumCycles)
{
    int i;

    for(i=0; i < iNumCycles; i++) {
        SCLKLow();
        SCLKHigh();
    }
    // function exits with CLK high.
}

// ============================================================================
// bReceiveBit()
// Clocks the SCLK pin (high-low-high) and reads the status of the SDATA pin
// after the rising edge.
//
// SCLK cannot run faster than the specified maximum frequency of 8MHz. Some 
// processors may need to have delays added after setting SCLK low and setting
// SCLK high in order to not exceed this specification. The maximum frequency 
// of SCLK should be measured as part of validation of the final program
//
// Returns:
//     0 if SDATA was low
//     1 if SDATA was high
// ============================================================================
unsigned char bReceiveBit(void)
{
    SCLKLow();
    SCLKHigh();
    if (fSDATACheck()) {
        return(1);
    }
    else {
        return(0);
    }
}          

// ============================================================================
// bReceiveByte()
// Calls ReceiveBit 8 times to receive one byte.
// Returns:
//     The 8-bit values recieved.
// ============================================================================
unsigned char bReceiveByte(void)
{
    unsigned char b;
    unsigned char bCurrByte = 0x00;

    for (b=0; b<8; b++) {
        bCurrByte = (bCurrByte<<1) + bReceiveBit();
    }
    return(bCurrByte);
}          


// ============================================================================
// SendByte()
// This routine sends up to one byte of a vector, one bit at a time.
//    bCurrByte   the byte that contains the bits to be sent.
//    bSize       the number of bits to be sent. Valid values are 1 to 8.
//
// SCLK cannot run faster than the specified maximum frequency of 8MHz. Some 
// processors may need to have delays added after setting SCLK low and setting
// SCLK high in order to not exceed this specification. The maximum frequency 
// of SCLK should be measured as part of validation of the final program
//
// There is no returned value.
// ============================================================================
void SendByte(unsigned char bCurrByte, unsigned char bSize)
{
    unsigned char b = 0;

    for(b=0; b<bSize; b++) {
        
		if (bCurrByte & 0x80)
            // Send a '1'
            SetSDATAHigh();        
        else
            // Send a '0'
            SetSDATALow();
		
		//Send one clock
		SCLKHigh();
        SCLKLow();
		
        bCurrByte = bCurrByte << 1;
    }
}

// ============================================================================
// SendVector()
// This routine sends the vector specifed. All vectors constant strings found
// in ISSP_Vectors.h.  The data line is returned to HiZ after the vector is
// sent.
//    bVect      a pointer to the vector to be sent.
//    nNumBits   the number of bits to be sent.
//    bCurrByte  scratch var to keep the byte to be sent.
//
// There is no returned value.
// ============================================================================
void SendVector(const unsigned char* bVect, unsigned int iNumBits)
{
    SetSDATAStrong();
    
    while(iNumBits >= 8) {
        SendByte(*(bVect), 8);
        iNumBits -= 8;
        bVect++;
    }
    
	if(iNumBits > 0)
		SendByte(*(bVect), iNumBits);
           
    SetSDATAHiZ();	
}


// ============================================================================
// fDetectHiLoTransition()
// Waits for transition from SDATA = 1 to SDATA = 0 with a 100 msec timeout.
// TRANSITION_TIMEOUT is a loop counter for a 100msec timeout when waiting for
// a high-to-low transition. The timing of the while(1) loops is calculated
// using iTimer.
//
// Returns:
//     0 if successful
//    -1 if timed out.
// ============================================================================
signed char fDetectHiLoTransition(void)
{
    // iTimer breaks out of the while loops if the wait in the two loops totals
    // more than 100 msec.
    static unsigned int iTimer;
    
	//Load the time out count for 100ms
	iTimer = TRANSITION_TIMEOUT;
	
	//Wait till SDATA is driven high by the target device
	while (1)
	{
		if (fSDATACheck())
			break;
		
		// If the wait is too long then timeout
        if (iTimer-- == 0) {
			return(ERROR);
        }
	}
	
	//Load the time out count for 100ms
	iTimer = TRANSITION_TIMEOUT;
	
	//Wait till SDATA is driven low by the target device 
	while (1)
	{
		if (!fSDATACheck())
			break;			
		
		// If the wait is too long then timeout
        if (iTimer-- == 0) {
			return (ERROR);
        }
	}
	
	return (PASS);
}

/* ((((((((((((((((((((( HIGH-LEVEL ISSP ROUTINE SECTION ))))))))))))))))))))))
   (( These functions are mostly made of calls to the low level routines     ))
   (( above.  This should isolate the processor-specific changes so that     ))
   (( these routines do not need to be modified.                             ))
   (((((((((((((((((((((((((((((((((((())))))))))))))))))))))))))))))))))))))))*/

#ifdef RESET_MODE
// ============================================================================
// fXRESInitializeTargetForISSP()
// Implements the intialization vectors for the device.
// Returns:
//     0 if successful
//     INIT_ERROR if timed out on handshake to the device.
// ============================================================================
signed char fXRESInitializeTargetForISSP(void)
{
    // Configure the pins for initialization
    SetSDATAHiZ();
    SetSCLKStrong();
    SCLKLow();
    SetXRESStrong();
  
    // Cycle reset and put the device in programming mode when it exits reset
    AssertXRES();
    Delay(XRES_CLK_DELAY);
    DeassertXRES();

    // !!! NOTE: 
    //  The timing spec that requires that the first Init-Vector happen within
    //  1 msec after the reset/power up. For this reason, it is not advisable
    //  to separate the above RESET_MODE or POWER_CYCLE_MODE code from the 
    //  Init-Vector instructions below. Doing so could introduce excess delay
    //  and cause the target device to exit ISSP Mode.

    // Send Initialization Vectors and detect Hi-Lo transition on SDATA
    SendVector(init1_v, num_bits_init1); 
	
	//Generate one clock to make M8C core to start executing the instructions 
	//from the test queue
	SCLKHigh();
	SCLKLow();
	
    if (fIsError = fDetectHiLoTransition()) {
        return(INIT_ERROR);
    }
    SendVector(wait_and_poll_end, num_bits_wait_and_poll_end);

    // Send Initialize 2 Vector
    SendVector(init2_v, num_bits_init2);
	
	//Generate one clock to make M8C core to start executing the instructions 
	//from the test queue
	SCLKHigh();
	SCLKLow();
	
    if (fIsError = fDetectHiLoTransition()) {
        return(INIT_ERROR);
    }
    SendVector(wait_and_poll_end, num_bits_wait_and_poll_end);      
     
    // Send Initialize 3 Vector NOTE: the proper vector based on Vdd of target
#ifdef TARGET_VOLTAGE_IS_5V
    SendVector(init3_5v, num_bits_init3_5v);          // Target Vdd = 5v
#else
    SendVector(init3_3v, num_bits_init3_3v);          // Target Vdd = 3.3v
#endif

	//Generate one clock to make M8C core to start executing the instructions 
	//from the test queue
	SCLKHigh();
	SCLKLow();
	
    SendVector(wait_and_poll_end, num_bits_wait_and_poll_end);

    // NOTE: DO NOT not wait for HiLo on SDATA after vector Init-3
    //       it does not occur (per spec).
    return(PASS);
}

#else  //else = the part is power cycle programmed

// ============================================================================
// fPowerCycleInitializeTargetForISSP()
// Implements the intialization vectors for the device.
// The first time fDetectHiLoTransition is called the Clk pin is highZ because
// the clock is not needed during acquire. 
// Returns:
//     0 if successful
//     INIT_ERROR if timed out on handshake to the device.
// ============================================================================
signed char fPowerCycleInitializeTargetForISSP(void)
{
    unsigned char n;

    // Set all pins to highZ to avoid back powering the PSoC through the GPIO
    // protection diodes.
    SetSCLKHiZ();   
    SetSDATAHiZ();
      
    // Turn on power to the target device before other signals
    SetTargetVDDStrong();
    ApplyTargetVDD();
	
    // wait 1msec for the power to stabilize
    for (n=0; n<10; n++) {
        Delay(DELAY100us);
    }

    // Set SCLK to high Z so there is no clock and wait for a high to low
    // transition on SDAT. SCLK is not needed this time.
    SetSCLKHiZ();
    if (fIsError = fDetectHiLoTransition()) {
        return(INIT_ERROR);
    }    

    // Configure the pins for initialization
    SetSDATAHiZ();
    SetSCLKStrong();
    SCLKLow();

    // !!! NOTE: 
    //  The timing spec that requires that the first Init-Vector happen within
    //  1 msec after the reset/power up. For this reason, it is not advisable
    //  to separate the above RESET_MODE or POWER_CYCLE_MODE code from the 
    //  Init-Vector instructions below. Doing so could introduce excess delay
    //  and cause the target device to exit ISSP Mode.

    // Send Initialization Vectors and detect Hi-Lo transition on SDATA
    SendVector(init1_v, num_bits_init1); 
	
	//Generate one clock to make M8C core to start executing the instructions 
	//from the test queue
	SCLKHigh();
	SCLKLow();
	
    if (fIsError = fDetectHiLoTransition()) {
        return(INIT_ERROR);
    }
    SendVector(wait_and_poll_end, num_bits_wait_and_poll_end);

    // Send Initialize 2 Vector
    SendVector(init2_v, num_bits_init2);
	
	//Generate one clock to make M8C core to start executing the instructions 
	//from the test queue
	SCLKHigh();
	SCLKLow();
	
    if (fIsError = fDetectHiLoTransition()) {
        return(INIT_ERROR);
    }
    SendVector(wait_and_poll_end, num_bits_wait_and_poll_end);
     
    // Send Initialize 3 Vector NOTE: the proper vector based on Vdd of target
    #ifdef TARGET_VOLTAGE_IS_5V
    SendVector(init3_5v, num_bits_init3_5v);          // Target Vdd = 5v
    #else
    SendVector(init3_3v, num_bits_init3_3v);          // Target Vdd = 3.3v
    #endif

	//Generate one clock to make M8C core to start executing the instructions 
	//from the test queue
	SCLKHigh();
	SCLKLow();
	
    SendVector(wait_and_poll_end, num_bits_wait_and_poll_end);

    // NOTE: DO NOT not wait for HiLo on SDATA after vector Init-3
    //       it does not occur (per spec).
    return(PASS);
}
#endif


// ============================================================================
// fVerifySiliconID()
// Returns:
//     0 if successful
//     Si_ID if timed out on handshake to the device.
// ============================================================================
signed char fVerifySiliconID(void)
{
    // Send ID-Setup vector set
    SendVector(id_setup_v, num_bits_id_setup);
	
	//Generate one clock to make M8C core to start executing the instructions 
	//from the test queue
	SCLKHigh();
	SCLKLow();	
	
    if (fIsError = fDetectHiLoTransition()) {
        return(SID_ERROR);
    }
    SendVector(wait_and_poll_end, num_bits_wait_and_poll_end);     

    //Send Read ID vector and get Target ID
    SendVector(read_id_v, 11);      // Read-MSB Vector is the first 11-Bits
    RunClock(2);                    // Two SCLK cycles between write & read
    bTargetID[0] = bReceiveByte();
    RunClock(1);
    SendVector(read_id_v+2, 12);    // 12 bits starting from the 3rd character

    RunClock(2);                    // Read-LSB Command
    bTargetID[1] = bReceiveByte();

    RunClock(1);
    SendVector(read_id_v+4, 1);     // 1 bit starting from the 5th character

    if (bTargetID[0] != target_id_v[0] || bTargetID[1] != target_id_v[1]) {
        return(SID_ERROR);
    }
    else {
        return(PASS);
    }
}


// ============================================================================
// fEraseTarget()
// Perform a bulk erase of the target device.
// Returns:
//     0 if successful
//     ERASE_ERROR if timed out on handshake to the device.
// ============================================================================
signed char fEraseTarget(void)
{
    SendVector(erase_all_v, num_bits_erase_all);
	
	//Generate one clock to make M8C core to start executing the instructions 
	//from the test queue
	SCLKHigh();
	SCLKLow();
	
	if (fIsError = fDetectHiLoTransition()) {
        return(ERASE_ERROR);
    }
    SendVector(wait_and_poll_end, num_bits_wait_and_poll_end);
    return(PASS);
}


// ============================================================================
// LoadTarget()
// Transfers data from array in Host to RAM buffer in the target.
// Returns the checksum of the data.
// ============================================================================
unsigned int iLoadTarget(void)
{
	unsigned char bTemp;
	unsigned int  iChecksumData = 0;

    // Set SDATA to Strong Drive here because SendByte() does not
    SetSDATAStrong();

    // Transfer the temporary RAM array into the target.
    // In this section, a 64-Byte array was specified by #define, so the entire
    // 64-Bytes are written in this loop.
    bTargetAddress = 0x00;
    bTargetDataPtr = 0x00;
          
    while(bTargetDataPtr < TARGET_DATABUFF_LEN) {     
        bTemp = abTargetDataOUT[bTargetDataPtr];
        iChecksumData += bTemp;

        SendByte(write_byte_start,num_bits_write_byte_start);     
        SendByte(bTargetAddress, num_bits_address_length);
        SendByte(bTemp, num_bits_data_length);
        SendByte(write_byte_end, num_bits_write_byte_end);
               
        // !!!NOTE:
        // SendByte() uses MSbits, so inc by '4' to put the 0..63 address into
        // the six MSBit locations.
        //
        // This can be confusing, but check the logic:
        //   The address is only 6-Bits long. The SendByte() subroutine will
        // send however-many bits, BUT...always reads them bits from left-to-
        // right. So in order to pass a value of 0..63 as the address using
        // SendByte(), we have to left justify the address by 2-Bits.
        //   This can be done easily by incrementing the address each time by
        // '4' rather than by '1'.

        bTargetAddress += 4;
        bTargetDataPtr++;
    }
    return(iChecksumData);
}


#ifdef MULTI_BANK
// ============================================================================
// SetBankNumber()
// Set the bank number in the target device.
// Returns:
//     none
// ============================================================================
void SetBankNumber(unsigned char bBankNumber)
{
    // Send the bank-select vector.
    SendVector(set_bank_number, num_bits_set_bank_number);

    // Set the drive here because SendByte() does not.
    SetSDATAStrong();
    SendByte(bBankNumber,num_bits_bank_number_length);
    SendVector(set_bank_number_end, num_bits_set_bank_number_end);
}
#endif


// ============================================================================
// fProgramTargetBlock()
// Program one block with data that has been loaded into a RAM buffer in the 
// target device.
// Returns:
//     0 if successful
//     BLOCK_ERROR if timed out on handshake to the device.
// ============================================================================
signed char fProgramTargetBlock(unsigned char bBankNumber, unsigned char bBlockNumber)
{
    // Send the block-select vector.
    SendVector(set_block_number, num_bits_set_block_number);

    // Set the drive here because SendByte() does not.
    SetSDATAStrong();
    SendByte(bBlockNumber,num_bits_block_number_length);
    SendByte(set_block_number_end, num_bits_set_block_number_end);

    // Send the program-block vector.
    SendVector(program_block, num_bits_program_block);
	
	//Generate one clock to make M8C core to start executing the instructions 
	//from the test queue
	SCLKHigh();
	SCLKLow();
	
    // wait for acknowledge from target.
    if (fIsError = fDetectHiLoTransition()) {
        return(BLOCK_ERROR);
    }
    // Send the Wait-For-Poll-End vector
    SendVector(wait_and_poll_end, num_bits_wait_and_poll_end);
    return(PASS);
}


// ============================================================================
// fAddTargetBankChecksum()
// Reads and adds the target bank checksum to the referenced accumulator.
// Returns:
//     0 if successful
//     VERIFY_ERROR if timed out on handshake to the device.
// ============================================================================
signed char fAccTargetBankChecksum(unsigned int* pAcc)
{
    SendVector(checksum_v, num_bits_checksum); 
	
	//Generate one clock to make M8C core to start executing the instructions 
	//from the test queue
	SCLKHigh();
	SCLKLow();
	
    if (fIsError = fDetectHiLoTransition()) {
        return(VERIFY_ERROR);
    }

    SendVector(wait_and_poll_end, num_bits_wait_and_poll_end);     

    //Send Read Checksum vector and get Target Checksum
    SendVector(read_checksum_v, 11);     // first 11-bits is ReadCKSum-MSB
    RunClock(2);                         // Two SCLKs between write & read
    *pAcc += (int)bReceiveByte() << 8;
    RunClock(1);                         
    SendVector(read_checksum_v + 2, 12); // 12 bits starting from 3rd character
    RunClock(2);                         // Read-LSB Command
    *pAcc += bReceiveByte();
    RunClock(1);
    SendVector(read_checksum_v + 3, 1);  // Send the final bit of the command
    return(PASS);    
}    


// ============================================================================
// ReStartTarget()
// After programming, the target PSoC must be reset to take it out of 
// programming mode. This routine performs a reset.
// ============================================================================
void ReStartTarget(void)
{
#ifdef RESET_MODE
    // Assert XRES, then release, then disable XRES-Enable
    AssertXRES();
    Delay(XRES_CLK_DELAY);
    DeassertXRES();
#else
    // Set all pins to highZ to avoid back powering the PSoC through the GPIO
    // protection diodes.
    SetSCLKHiZ();   
    SetSDATAHiZ();
    // Cycle power on the target to cause a reset
    RemoveTargetVDD();
    Delay(POWER_CYCLE_DELAY);
    ApplyTargetVDD();
#endif
}


// ============================================================================
// fVerifyTargetBlock()
// Verify the block just written to. This can be done byte-by-byte before the
// protection bits are set.
// Returns:
//     0 if successful
//     BLOCK_ERROR if timed out on handshake to the device.
// ============================================================================
signed char fVerifyTargetBlock(unsigned char bBankNumber, unsigned char bBlockNumber)
{	
    SendVector(set_block_number, num_bits_set_block_number);

    // Set the drive here because SendByte() does not
    SetSDATAStrong();
    SendByte(bBlockNumber,num_bits_block_number_length);
    SendByte(set_block_number_end, num_bits_set_block_number_end);
     
    SendVector(verify_setup_v, num_bits_verify_setup);
	
	//Generate one clock to make M8C core to start executing the instructions 
	//from the test queue
	SCLKHigh();
	SCLKLow();
	
    if (fIsError = fDetectHiLoTransition()) {		
        return(BLOCK_ERROR);
    }
    SendVector(wait_and_poll_end, num_bits_wait_and_poll_end);     

    bTargetAddress = 0;
    bTargetDataPtr = 0;
     
    while(bTargetDataPtr < TARGET_DATABUFF_LEN) {
        //Send Read Byte vector and then get a byte from Target
        SendVector(read_byte_v, num_bits_read_byte_start);
        // Set the drive here because SendByte() does not
        SetSDATAStrong();
        SendByte(bTargetAddress,num_bits_address_length);

        RunClock(2);       // Run two SCLK cycles between writing and reading
        SetSDATAHiZ();     // Set to HiZ so Target can drive SDATA
        bTargetDataIN = bReceiveByte();

        RunClock(1);
        SendVector(read_byte_v + 1, num_bits_read_byte_end);     // Send the ReadByte Vector End

		// Test the Byte that was read from the Target against the original
        // value (already in the 64-Byte array "abTargetDataOUT[]"). If it
        // matches, then bump the address & pointer,loop-back and continue.
        // If it does NOT match abort the loop and return and error.	
        if (bTargetDataIN != abTargetDataOUT[bTargetDataPtr])
		{
         	return(BLOCK_ERROR);
		}
        bTargetDataPtr++;
        // Increment the address by four to accomodate 6-Bit addressing
        // (puts the 6-bit address into MSBit locations for "SendByte()").
        bTargetAddress += 4;
    }		
    return(PASS);
}


// ============================================================================
// fSecureTargetFlash()
// Before calling, load the array, abTargetDataOUT, with the desired security
// settings using LoadSecurityData().
// This function can be called multiple times with different SecurityTypes as needed for
// particular Flash Blocks.
// Returns:
//     0 if successful
//     SECURITY_ERROR if timed out on handshake to the device.
// ============================================================================
signed char fSecureTargetFlash(void)
{
	unsigned char bTemp;

    // Transfer the temporary RAM array into the target
    bTargetAddress = 0x00;
    bTargetDataPtr = 0x00;
    SetSDATAStrong();
    while(bTargetDataPtr < SECURITY_BYTES_PER_BANK) {     
        bTemp = abTargetDataOUT[bTargetDataPtr];
        SendByte(write_byte_start,num_bits_write_byte_start);     
        SendByte(bTargetAddress, num_bits_address_length);
        SendByte(bTemp, num_bits_data_length);
        SendByte(write_byte_end, num_bits_write_byte_end);
           
        // SendBytes() uses MSBits, so increment the address by '4' to put
        // the 0..n address into the six MSBit locations
        bTargetAddress += 4;
        bTargetDataPtr++;
    }

    SendVector(security_v, num_bits_security);
	
	//Generate one clock to make M8C core to start executing the instructions 
	//from the test queue
	SCLKHigh();
	SCLKLow();
	
    if (fIsError = fDetectHiLoTransition()) {
        return(SECURITY_ERROR);
    }
    SendVector(wait_and_poll_end, num_bits_wait_and_poll_end);
    return(PASS);
}

// ============================================================================
// fVerifySecurity()
// This function reads the security settings stored in the target flash. 
// User should add the code in this function to compare the read value 
// (stored in abTargetDataOUT)with the desired value. 
// Returns:
//     0 if successful
//     SECURITY_ERROR if timed out on handshake to the device.
// ============================================================================

signed char fVerifySecurity(void)
{
	//Send the vector to read the security bits
	SendVector(securityVerification_v, num_bits_securityVerification);
	
	//Generate one clock to make M8C core to start executing the instructions 
	//from the test queue
	SCLKHigh();
	SCLKLow();
	
	if (fIsError = fDetectHiLoTransition()) {
        return(SECURITY_ERROR);
    }
	SendVector(wait_and_poll_end, num_bits_wait_and_poll_end);
	
	bTargetAddress = 0;
    bTargetDataPtr = 0;
    
	/* Read the security bytes */	
    while(bTargetDataPtr < SECURITY_BYTES_PER_BANK) {
        //Send Read Byte vector and then get a byte from Target
        SendVector(read_byte_v, num_bits_read_byte_start);
        // Set the drive here because SendByte() does not
        SetSDATAStrong();
        SendByte(bTargetAddress,num_bits_address_length);

        RunClock(2);       // Run two SCLK cycles between writing and reading
        SetSDATAHiZ();     // Set to HiZ so Target can drive SDATA
        bTargetDataIN = bReceiveByte();

        RunClock(1);
        SendVector(read_byte_v + 1, num_bits_read_byte_end);     // Send the ReadByte Vector End

		// *********************************************************************
		// ****                      USER ATTENTION REQUIRED                ****
		// *********************************************************************
		// Add your code here to verify the security value. Currently,
		// known value of 0x00 (U - Unprotected) is written in the function
		// fSecureTargetFlash()		
		
		if (bTargetDataIN != 0x00) 
            return(SECURITY_ERROR);
		
		/* Keep copy of the received security byte for sending over UART */
		abTargetDataOUT[bTargetDataPtr] = bTargetDataIN;
		
		bTargetDataPtr++;   
		
		// SendBytes() uses MSBits, so increment the address by '4' to put
        // the 0..n address into the six MSBit locations
        bTargetAddress += 4;
    }
    return(PASS);
	
}

// ****************************************************************************
// ****                        PROCESSOR SPECIFIC                          ****
// ****************************************************************************
// ****                      USER ATTENTION REQUIRED                       ****
// ****************************************************************************
// LoadProgramData()
// The final application should load program data from HEX file generated by 
// PSoC Designer into a 64 byte host ram buffer.
//    1. Read data from next line in hex file into ram buffer. One record 
//      (line) is 64 bytes of data.
//    2. Check host ram buffer + record data (Address, # of bytes) against hex
//       record checksum at end of record line
//    3. If error reread data from file or abort
//    4. Exit this Function and Program block or verify the block.
// This demo program will, instead, load predetermined data into each block.
// The demo does it this way because there is no comm link to get program data.
// ****************************************************************************
void LoadProgramData(unsigned char bBlockNum, unsigned char bBankNum)
{
    // >>> The following code is for demo use only. <<<
    // Below code fills buffer for demo
    
    for (bTargetDataPtr = 0; bTargetDataPtr < TARGET_DATABUFF_LEN; bTargetDataPtr++) {
        abTargetDataOUT[bTargetDataPtr] = bTargetDataPtr + bBlockNum + bBankNum ;
    }	

    // Note:
    // Error checking should be added for the final version as noted above.
    // For demo use this function just returns VOID.
}


// ****************************************************************************
// ****                        PROCESSOR SPECIFIC                          ****
// ****************************************************************************
// ****                      USER ATTENTION REQUIRED                       ****
// ****************************************************************************
// LoadSecurityData()
// Load security data from hex file into 64 byte host ram buffer. In a fully 
// functional program (not a demo) this routine should do the following:
//    1. Read data from security record in hex file into ram buffer. 
//    2. Check host ram buffer + record data (Address, # of bytes) against hex
//       record checksum at end of record line
//    3. If error reread security data from file or abort
//    4. Exit this Function and Program block
// In this demo routine, all of the security data is set to unprotected (0x00).
// This function always returns PASS. The flag return is reserving
// functionality for non-demo versions.
// ****************************************************************************
signed char LoadSecurityData(unsigned char bBankNum)
{
    // >>> The following code is for demo use only. <<<
        
	unsigned char bStart, bLength, bType;
	
	bStart = 0; //start with security data for first block in the bank
	bLength = SECURITY_BYTES_PER_BANK;	//this covers for all the blocks in the bank
	bType = 0x00;	//unprotected 
	
	// Write the desired security-bytes for the range specified
    for (bTargetDataPtr = bStart; bTargetDataPtr < bLength; bTargetDataPtr++) {
		abTargetDataOUT[bTargetDataPtr] = bType;		
    }
		    
    // Note:
    // Error checking should be added for the final version as noted above.
    // For demo use this function just returns PASS.
    return(PASS);
}

#endif  //(PROJECT_REV_)
// end of file ISSP_PacketLayer.c
