alexey1234/arduino_hssp/docs/HSSP_CY8Cxxxx/HSSP_CY8Cxxxx/HSSP_CY8Cxxxx/issp_vectors.h

// filename: ISSP_Vectors.h
// Copyright 2015, Cypress Semiconductor Corporation.
//
// This software is owned by Cypress Semiconductor Corporation (Cypress)
// and is protected by and subject to worldwide patent protection (United
// States and foreign), United States copyright laws and international 
// treaty provisions. Cypress hereby grants to licensee a personal, 
// non-exclusive, non-transferable license to copy, use, modify, create 
// derivative works of, and compile the Cypress Source Code and derivative 
// works for the sole purpose of creating custom software in support of 
// licensee product to be used only in conjunction with a Cypress integrated 
// circuit as specified in the applicable agreement. Any reproduction, 
// modification, translation, compilation, or representation of this 
// software except as specified above is prohibited without the express 
// written permission of Cypress.
//
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
// Use may be limited by and subject to the applicable Cypress software
// license agreement.
//
//-----------------------------------------------------------------------------

#ifndef INC_ISSP_VECTORS
#define INC_ISSP_VECTORS

#include "ISSP_Revision.h"
#ifdef PROJECT_REV_300

#include "ISSP_directives.h"

// ------------------------- PSoC CY8CTST1x0 Devices ---------------------------
// Modifying these tables is NOT recommendended. Doing so will all but
// guarantee an ISSP error, unless updated vectors have been recommended or
// provided by Cypress Semiconductor.
// ----------------------------------------------------------------------------
#ifdef CY8CTST110_32LTXI
    const unsigned char target_id_v[] = {0x06, 0x38};     //ID for CY8CTST110_32LTXI
#endif
#ifdef CY8CTST110_00PVXI
    const unsigned char target_id_v[] = {0x06, 0x39};     //ID for CY8CTST110_00PVXI
#endif
#ifdef CY8CTST120_56LTXI
    const unsigned char target_id_v[] = {0x06, 0x1F};     //ID for CY8CTST120_56LTXI
#endif
#ifdef CY8CTST120_00AXI
    const unsigned char target_id_v[] = {0x06, 0x1B};     //ID for CY8CTST120_00AXI
#endif

// ------------------------- PSoC CY8CTMG1x0 Devices ---------------------------
// Modifying these tables is NOT recommendended. Doing so will all but
// guarantee an ISSP error, unless updated vectors have been recommended or
// provided by Cypress Semiconductor.
// ----------------------------------------------------------------------------
#ifdef CY8CTMG110_32LTXI
    const unsigned char target_id_v[] = {0x07, 0x38};     //ID for CY8CTMG110_32LTXI
#endif
#ifdef CY8CTMG110_00PVXI
    const unsigned char target_id_v[] = {0x07, 0x39};     //ID for CY8CTMG110_00PVXI
#endif
#ifdef CY8CTMG120_56LTXI
    const unsigned char target_id_v[] = {0x07, 0x1F};     //ID for CY8CTMG120_56LTXI
#endif
#ifdef CY8CTMG120_00AXI
    const unsigned char target_id_v[] = {0x07, 0x1B};     //ID for CY8CTMG120_00AXI
#endif

// ------------------------- PSoC CY8CTMA120 Devices ---------------------------
// Modifying these tables is NOT recommendended. Doing so will all but
// guarantee an ISSP error, unless updated vectors have been recommended or
// provided by Cypress Semiconductor.
// ----------------------------------------------------------------------------
#ifdef CY8CTMA120_56LTXI
    const unsigned char target_id_v[] = {0x05, 0x1F};     //ID for CY8CTMA120_56LTXI
#endif
#ifdef CY8CTMA120_100BVXI
    const unsigned char target_id_v[] = {0x05, 0x59};     //ID for CY8CTMA120_100BVXI
#endif
#ifdef CY8CTMA120_00AXI
    const unsigned char target_id_v[] = {0x05, 0x1B};     //ID for CY8CTMA120_00AXI
#endif

// ------------------------- PSoC CY8C21x23 Devices ---------------------------
// Modifying these tables is NOT recommendended. Doing so will all but
// guarantee an ISSP error, unless updated vectors have been recommended or
// provided by Cypress Semiconductor.
// ----------------------------------------------------------------------------
#ifdef CY8C21123
    const unsigned char target_id_v[] = {0x00, 0x17};     //ID for CY8C21123
#endif
#ifdef CY8C21223
    const unsigned char target_id_v[] = {0x00, 0x18};     //ID for CY8C21223
#endif
#ifdef CY8C21323
    const unsigned char target_id_v[] = {0x00, 0x19};     //ID for CY8C2132
#endif
#ifdef CY8C21002
    const unsigned char target_id_v[] = {0x00, 0x3F};     //ID for CY8C21x23 ICE pod
#endif

// ------------------------- PSoC CY8C21x34 Devices ---------------------------
// Modifying these tables is NOT recommendended. Doing so will all but
// guarantee an ISSP error, unless updated vectors have been recommended or
// provided by Cypress Semiconductor.
// ----------------------------------------------------------------------------
#ifdef CY8C21234
    const unsigned char target_id_v[] = {0x00, 0x36};     //ID for CY8C21234
#endif
#ifdef CY8C21334
    const unsigned char target_id_v[] = {0x00, 0x37};     //ID for CY8C21334
#endif
#ifdef CY8C21434
    const unsigned char target_id_v[] = {0x00, 0x38};     //ID for CY8C21434
#endif
#ifdef CY8C21534
    const unsigned char target_id_v[] = {0x00, 0x40};     //ID for CY8C21534
#endif
#ifdef CY8C21634
    const unsigned char target_id_v[] = {0x00, 0x49};     //ID for CY8C21634
#endif
#ifdef CY8C21001
    const unsigned char target_id_v[] = {0x00, 0x39};     //ID for CY8C21x34 ICE pod
#endif

// ------------------------- PSoC CY8C21x45 Devices ---------------------------
// Modifying these tables is NOT recommendended. Doing so will all but
// guarantee an ISSP error, unless updated vectors have been recommended or
// provided by Cypress Semiconductor.
// ----------------------------------------------------------------------------
#ifdef CY8C21345
    const unsigned char target_id_v[] = {0x00, 0xD3};     //ID for CY8C21345  
#endif

// ------------------------- PSoC CY8C22x45 Devices ---------------------------
// Modifying these tables is NOT recommendended. Doing so will all but
// guarantee an ISSP error, unless updated vectors have been recommended or
// provided by Cypress Semiconductor.
// ----------------------------------------------------------------------------
#ifdef CY8C22045
    const unsigned char target_id_v[] = {0x00, 0xD0};     //ID for CY8C22045
#endif
#ifdef CY8C22345
    const unsigned char target_id_v[] = {0x00, 0xD1};     //ID for CY8C22345
#endif
#ifdef CY8C22545
    const unsigned char target_id_v[] = {0x00, 0xD2};     //ID for CY8C22545
#endif

// ------------------------- PSoC CY8C23x33 Devices ---------------------------
// Modifying these tables is NOT recommendended. Doing so will all but
// guarantee an ISSP error, unless updated vectors have been recommended or
// provided by Cypress Semiconductor.
// ----------------------------------------------------------------------------
#ifdef CY8C23033
    const unsigned char target_id_v[] = {0x08, 0xB2};     //ID for CY8C23033
#endif
#ifdef CY8C23433
    const unsigned char target_id_v[] = {0x08, 0xB0};     //ID for CY8C23433
#endif
#ifdef CY8C23533
    const unsigned char target_id_v[] = {0x08, 0xB1};     //ID for CY8C23533
#endif

// ------------------------- PSoC CY8C24x23A Devices --------------------------
// Modifying these tables is NOT recommendended. Doing so will all but
// guarantee an ISSP error, unless updated vectors have been recommended or
// provided by Cypress Semiconductor.
// ----------------------------------------------------------------------------
#ifdef CY8C24123A
    const unsigned char target_id_v[] = {0x00, 0x32};     //ID for CY8C24123A
#endif
#ifdef CY8C24223A
    const unsigned char target_id_v[] = {0x00, 0x33};     //ID for CY8C24223A
#endif
#ifdef CY8C24423A
    const unsigned char target_id_v[] = {0x00, 0x34};     //ID for CY8C24423A
#endif
#ifdef CY8C24000A
    const unsigned char target_id_v[] = {0x00, 0x35};     //ID for CY8C24x23A ICE pod
#endif


// ------------------------- PSoC CY8C24x94 Devices ---------------------------
// Modifying these tables is NOT recommendended. Doing so will all but
// guarantee an ISSP error, unless updated vectors have been recommended or
// provided by Cypress Semiconductor.
// ----------------------------------------------------------------------------
#ifdef CY8C24794
    const unsigned char target_id_v[] = {0x00, 0x1D};     //ID for CY8C24794
#endif
#ifdef CY8C24894
    const unsigned char target_id_v[] = {0x00, 0x1F};     //ID for CY8C24894
#endif
#ifdef CY8C24994
    const unsigned char target_id_v[] = {0x00, 0x59};     //ID for CY8C24994
#endif
#ifdef CY8C24094
    const unsigned char target_id_v[] = {0x00, 0x1B};     //ID for CY8C24094
#endif


// ------------------------- PSoC CY8C27x43 Devices ---------------------------
// Modifying these tables is NOT recommendended. Doing so will all but
// guarantee an ISSP error, unless updated vectors have been recommended or
// provided by Cypress Semiconductor.
// ----------------------------------------------------------------------------
#ifdef CY8C27143
    const unsigned char target_id_v[] = {0x00, 0x09};     //ID for CY8C27143
#endif
#ifdef CY8C27243
    const unsigned char target_id_v[] = {0x00, 0x0A};     //ID for CY8C27243
#endif
#ifdef CY8C27443
    const unsigned char target_id_v[] = {0x00, 0x0B};     //ID for CY8C27443
#endif
#ifdef CY8C27543
    const unsigned char target_id_v[] = {0x00, 0x0C};     //ID for CY8C27543
#endif
#ifdef CY8C27643
    const unsigned char target_id_v[] = {0x00, 0x0D};     //ID for CY8C27643
#endif
#ifdef CY8C27002
    const unsigned char target_id_v[] = {0x00, 0x0E};     //ID for CY8C27x43 ICE pod
#endif

// ------------------------- PSoC CY8C28xxx Devices ---------------------------
// Modifying these tables is NOT recommendended. Doing so will all but
// guarantee an ISSP error, unless updated vectors have been recommended or
// provided by Cypress Semiconductor.
// ----------------------------------------------------------------------------
#ifdef CY8C28000
    const unsigned char target_id_v[] = {0x00, 0xE0};     //ID for CY8C28000 ICE pod
#endif
#ifdef CY8C28445
    const unsigned char target_id_v[] = {0x00, 0xE1};     //ID for CY8C28445
#endif
#ifdef CY8C28545
    const unsigned char target_id_v[] = {0x00, 0xE2};     //ID for CY8C28545
#endif
#ifdef CY8C28645
    const unsigned char target_id_v[] = {0x00, 0xE3};     //ID for CY8C28645
#endif
#ifdef CY8C28x43
    const unsigned char target_id_v[] = {0x00, 0xE4};     //ID for CY8C28x43
#endif
#ifdef CY8C28452
    const unsigned char target_id_v[] = {0x00, 0xE5};     //ID for CY8C28452
#endif
#ifdef CY8C28x13
    const unsigned char target_id_v[] = {0x00, 0xE6};     //ID for CY8C28x13
#endif
#ifdef CY8C28x33
    const unsigned char target_id_v[] = {0x00, 0xE7};     //ID for CY8C28x33
#endif
#ifdef CY8C28403
    const unsigned char target_id_v[] = {0x00, 0xE8};     //ID for CY8C28403
#endif
#ifdef CY8C28623
    const unsigned char target_id_v[] = {0x00, 0xE9};     //ID for CY8C28623
#endif

// ------------------------- PSoC CY8C29x66 Devices ---------------------------
// Modifying these tables is NOT recommendended. Doing so will all but
// guarantee an ISSP error, unless updated vectors have been recommended or
// provided by Cypress Semiconductor.
// ----------------------------------------------------------------------------
#ifdef CY8C29466
    const unsigned char target_id_v[] = {0x00, 0x2A};     //ID for CY8C29466
#endif
#ifdef CY8C29566
    const unsigned char target_id_v[] = {0x00, 0x2B};     //ID for CY8C29566
#endif
#ifdef CY8C29666
    const unsigned char target_id_v[] = {0x00, 0x2C};     //ID for CY8C29666
#endif
#ifdef CY8C29866
    const unsigned char target_id_v[] = {0x00, 0x2D};     //ID for CY8C29866
#endif
#ifdef CY8C29002
    const unsigned char target_id_v[] = {0x00, 0x2E};     //ID for CY8C29002
#endif


// ---- CY8C21x23, CY8C21x34, CY8C23x33, CY8C27x43, TST110 & TMG110 Checksum Setup Vectors ----
// Modifying these tables is NOT recommendended. Doing so will all but
// guarantee an ISSP error, unless updated vectors have been recommended or
// provided by Cypress Semiconductor.
// ---------------------------------------------------------------------------------
#ifdef CHECKSUM_SETUP_21_23_27_TST110_TMG110
    const unsigned int num_bits_checksum = 286;
    const unsigned char checksum_v[] =
    {
        0xDE, 0xE0, 0x1F, 0x7B, 0x00, 0x79, 0xF0, 0x75,
        0xE7, 0xC8, 0x1F, 0xDE, 0xA0, 0x1F, 0x7A, 0x01,
        0xF9, 0xF7, 0x01, 0xF7, 0xC9, 0x87, 0xDF, 0x48,
        0x1E, 0x7D, 0x00, 0x7D, 0xE0, 0x0F, 0xF7, 0xC0,
        0x07, 0xDF, 0xE2, 0x5C
                     
//          0b11011110,0b11100000,0b00011111,0b01111011,0b00000000,0b01111001,0b11110000,0b01110101,
//          0b11100111,0b11001000,0b00011111,0b11011110,0b10100000,0b00011111,0b01111010,0b00000001,
//          0b11111001,0b11110111,0b00000001,0b11110111,0b11001001,0b10000111,0b11011111,0b01001000,
//          0b00011110,0b01111101,0b00000000,0b01111101,0b11100000,0b00001111,0b11110111,0b11000000,
//          0b00000111,0b11011111,0b11100010,0b01011100
    };
#endif


// -------------- CY8C24x23 & CY8C24x23A Checksum Setup Vectors ---------------
// Modifying these tables is NOT recommendended. Doing so will all but
// guarantee an ISSP error, unless updated vectors have been recommended or
// provided by Cypress Semiconductor.
// ----------------------------------------------------------------------------
#ifdef CHECKSUM_SETUP_24_24A
    const unsigned int num_bits_checksum = 286;
    const unsigned char checksum_v[] =
    {
        0xDE, 0xE0, 0x1F, 0x7B, 0x00, 0x79, 0xF0, 0x75,
        0xE7, 0xC8, 0x1F, 0xDE, 0xA0, 0x1F, 0x7A, 0x01,
        0xF9, 0xF7, 0x01, 0xF7, 0xC9, 0x87, 0xDF, 0x48,
        0x1E, 0x7D, 0x20, 0x7D, 0xE0, 0x0F, 0xF7, 0xC0,
        0x07, 0xDF, 0xE2, 0x5C
                     
//          0b11011110,0b11100000,0b00011111,0b01111011,0b00000000,0b01111001,0b11110000,0b01110101,
//          0b11100111,0b11001000,0b00011111,0b11011110,0b10100000,0b00011111,0b01111010,0b00000001,
//          0b11111001,0b11110111,0b00000001,0b11110111,0b11001001,0b10000111,0b11011111,0b01001000,
//          0b00011110,0b01111101,0b00100000,0b01111101,0b11100000,0b00001111,0b11110111,0b11000000,
//          0b00000111,0b11011111,0b11100010,0b01011100
    };
#endif


// ---- CY8C21x45,CY8C22x45,CY8C24x94, CY8C28xxx, CY8C29x66, TST120, TMG120, & TMA120 Checksum Setup Vectors ----
// Modifying these tables is NOT recommendended. Doing so will all but
// guarantee an ISSP error, unless updated vectors have been recommended or
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
//		0b00011111, 0b01111100, 0b10011000, 0b01111101, 0b11110100, 0b10000001, 0b11110111, 0b10000000,
//		0b10000111, 0b11011111, 0b00000000, 0b00011111, 0b01111111, 0b10001001, 0b01110000		
	};

#endif  //(PROJECT_REV_)
#endif  //(INC_ISSP_VECTORS)
//end of file ISSP_Vectors.h
