alexey1234/arduino_hssp/(commit log)

2025-03-31 add schematic
2025-03-31 add led blink when work and TARGET VDD work as expected
2025-03-31 Update README.md
    For my board need this connection
2025-04-08 Create my target board.jpg
2025-04-22 analog reference use and off builting led
2025-04-23 correct schematic picture
